JianLi0-0/Balancing-Cart/stm32/inverted_single_pendulum/balanced_car/balanced_car.pdf

## balanced_car Project Configuration Report

# 1. Description

## 1.1. Project

Project Name | balanced_car
Board Name | custom
Generated with: | STM32CubeMX 4.26.0
Date | 03/05/2019

## 1.2. MCU

MCU Series | STM32F1
MCU Line | STM32F103
MCU name | STM32F103C8Tx
MCU Package | LQFP48
MCU Pin number | 48

# 2. Pinout Configuration

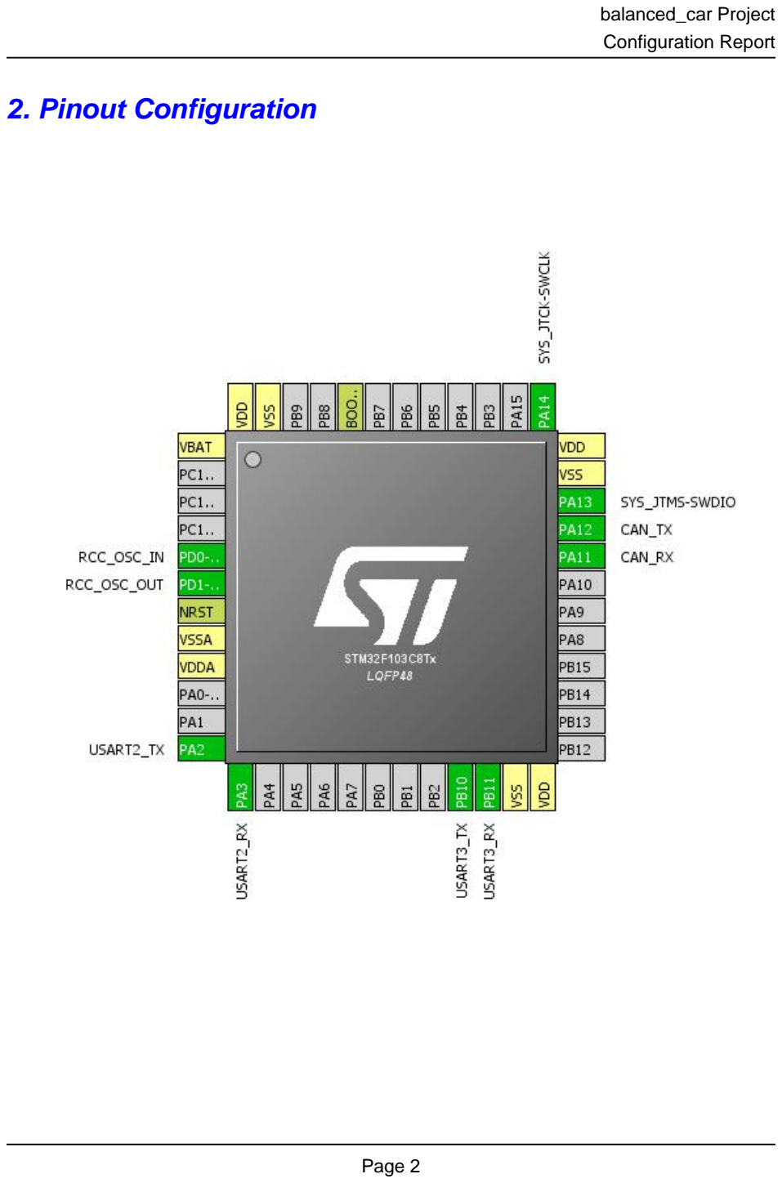
[picture p1: page 2]

# 3. Pins Configuration

Pin Number LQFP48 | Pin Name (function after reset) | Pin Type | Alternate Function(s) | Label
1 | VBAT | Power
5 | PD0-OSC_IN | I/O | RCC_OSC_IN
6 | PD1-OSC_OUT | I/O | RCC_OSC_OUT
7 | NRST | Reset
8 | VSSA | Power
9 | VDDA | Power
12 | PA2 | I/O | USART2_TX
13 | PA3 | I/O | USART2_RX
21 | PB10 | I/O | USART3_TX
22 | PB11 | I/O | USART3_RX
23 | VSS | Power
24 | VDD | Power
32 | PA11 | I/O | CAN_RX
33 | PA12 | I/O | CAN_TX
34 | PA13 | I/O | SYS_JTMS-SWDIO
35 | VSS | Power
36 | VDD | Power
37 | PA14 | I/O | SYS_JTCK-SWCLK
44 | BOOT0 | Boot
47 | VSS | Power
48 | VDD | Power

# 4. Clock Tree Configuration

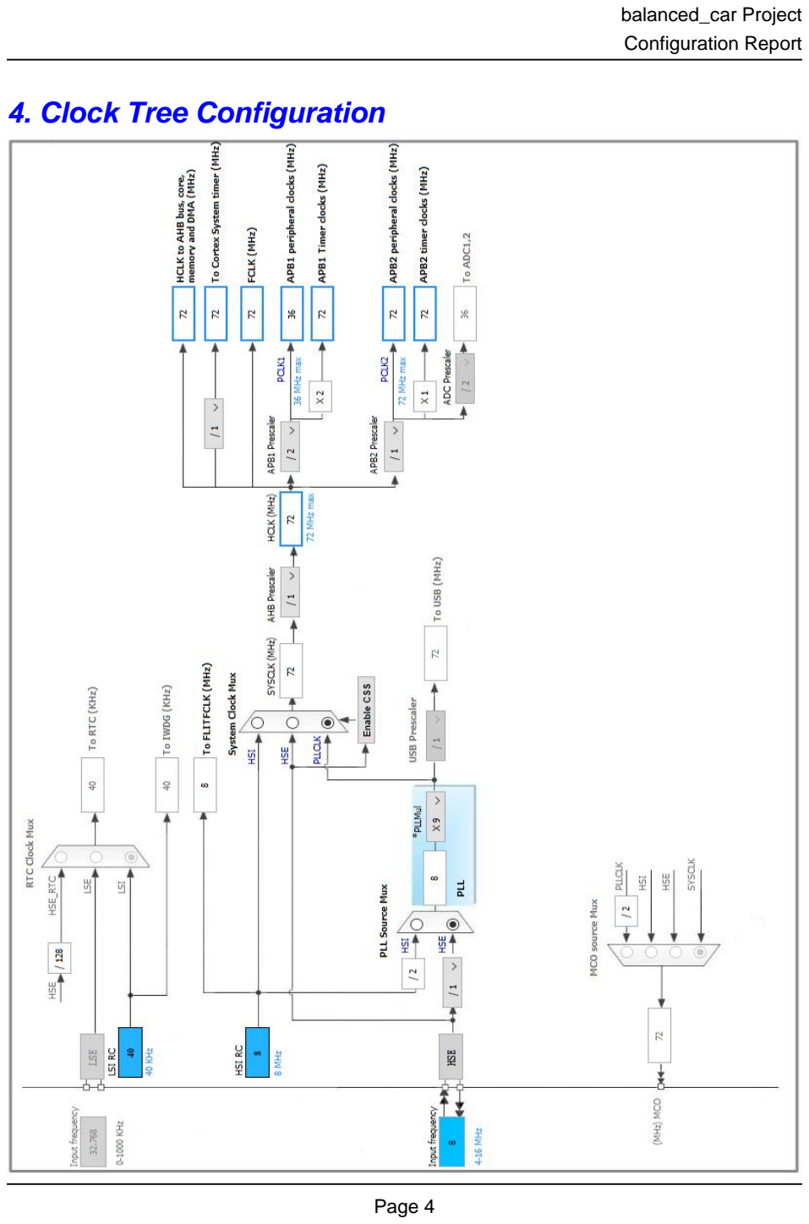
[picture p2: page 4]

# 5. IPs and Middleware Configuration

# 5.1. CAN

## mode: Mode 5.1.1. Parameter Settings:

### Bit Timings Parameters:

Prescaler (for Time Quantum) | 4 *
Time Quantum | 111.11111111111111 *
Time Quanta in Bit Segment 1 | 5 Times *
Time Quanta in Bit Segment 2 | 3 Times *
Time for one Bit | 333 *
ReSynchronization Jump Width | 1 Time

### Basic Parameters:

Time Triggered Communication Mode | Disable
Automatic Bus-Off Management | Disable
Automatic Wake-Up Mode | Disable
No-Automatic Retransmission | Disable
Receive Fifo Locked Mode | Disable
Transmit Fifo Priority | Disable

### Advanced Parameters:

Operating Mode | Normal

# 5.2. RCC

## High Speed Clock (HSE): Crystal/Ceramic Resonator 5.2.1. Parameter Settings:

### System Parameters:

VDD voltage (V) | 3.3
Prefetch Buffer | Enabled
Flash Latency(WS) | 2 WS (3 CPU cycle)

### RCC Parameters:

HSI Calibration Value | 16
HSE Startup Timout Value (ms) | 100
LSE Startup Timout Value (ms) | 5000

# 5.3. SYS

## Debug: Serial Wire Timebase Source: SysTick

# 5.4. TIM2

## Clock Source : Internal Clock 5.4.1. Parameter Settings:

### Counter Settings:

Prescaler (PSC - 16 bits value) | 3600-1 *
Counter Mode | Up
Counter Period (AutoReload Register - 16 bits value ) | 0
Internal Clock Division (CKD) | No Division
auto-reload preload | Disable

### Trigger Output (TRGO) Parameters:

Master/Slave Mode (MSM bit) | Disable (Trigger input effect not delayed)
Trigger Event Selection | Reset (UG bit from TIMx_EGR)

# 5.5. USART2

## Mode: Asynchronous 5.5.1. Parameter Settings:

### Basic Parameters:

Baud Rate | 115200
Word Length | 8 Bits (including Parity)
Parity | None
Stop Bits | 1

### Advanced Parameters:

Data Direction | Receive and Transmit
Over Sampling | 16 Samples

# 5.6. USART3

## Mode: Asynchronous

## 5.6.1. Parameter Settings:

### Basic Parameters:

Baud Rate | 115200
Word Length | 8 Bits (including Parity)
Parity | None
Stop Bits | 1

### Advanced Parameters:

Data Direction | Receive and Transmit
Over Sampling | 16 Samples

### * User modified value

# 6. System Configuration

# 6.1. GPIO configuration

IP | Pin | Signal | GPIO mode | GPIO pull/up pull down | Max Speed | User Label
CAN | PA11 | CAN_RX | Input mode | No pull-up and no pull-down | n/a
| PA12 | CAN_TX | Alternate Function Push Pull | n/a | High *
RCC | PD0-OSC_IN | RCC_OSC_IN | n/a | n/a | n/a
| PD1-OSC_OUT | RCC_OSC_OUT | n/a | n/a | n/a
SYS | PA13 | SYS_JTMS-SWDIO | n/a | n/a | n/a
| PA14 | SYS_JTCK-SWCLK | n/a | n/a | n/a
USART2 | PA2 | USART2_TX | Alternate Function Push Pull | n/a | High *
| PA3 | USART2_RX | Input mode | No pull-up and no pull-down | n/a
USART3 | PB10 | USART3_TX | Alternate Function Push Pull | n/a | High *
| PB11 | USART3_RX | Input mode | No pull-up and no pull-down | n/a

# 6.2. DMA configuration

## nothing configured in DMA service

# 6.3. NVIC configuration

Interrupt Table | Enable | Preenmption Priority | SubPriority
Non maskable interrupt | true | 0 | 0
Hard fault interrupt | true | 0 | 0
Memory management fault | true | 0 | 0
Prefetch fault, memory access fault | true | 0 | 0
Undefined instruction or illegal state | true | 0 | 0
System service call via SWI instruction | true | 0 | 0
Debug monitor | true | 0 | 0
Pendable request for system service | true | 0 | 0
System tick timer | true | 0 | 0
USB high priority or CAN TX interrupts | true | 0 | 0
USB low priority or CAN RX0 interrupts | true | 0 | 0
TIM2 global interrupt | true | 0 | 0
USART2 global interrupt | true | 0 | 0
USART3 global interrupt | true | 0 | 0
PVD interrupt through EXTI line 16 | unused
Flash global interrupt | unused
RCC global interrupt | unused
CAN RX1 interrupt | unused
CAN SCE interrupt | unused

### * User modified value

# 7. Power Consumption Calculator report

### 7.1. Microcontroller Selection

Series | STM32F1
Line | STM32F103
MCU | STM32F103C8Tx
Datasheet | 13587_Rev17

### 7.2. Parameter Selection

Temperature | 25
Vdd | 3.3

# 8. Software Project

## 8.1. Project Settings

Name | Value
Project Name | balanced_car
Project Folder | G:\MX\balanced_car
Toolchain / IDE | MDK-ARM V5
Firmware Package Name and Version | STM32Cube FW_F1 V1.6.1

## 8.2. Code Generation Settings

Name | Value
STM32Cube Firmware Library Package | Copy all used libraries into the project folder
Generate peripheral initialization as a pair of '.c/.h' files | Yes
Backup previously generated files when re-generating | No
Delete previously generated files when not re-generated | Yes
Set all free pins as analog (to optimize the power consumption) | No

# 9. Software Pack Report
