JianLi0-0/Balancing-Cart/simulation/truewheel.jpg

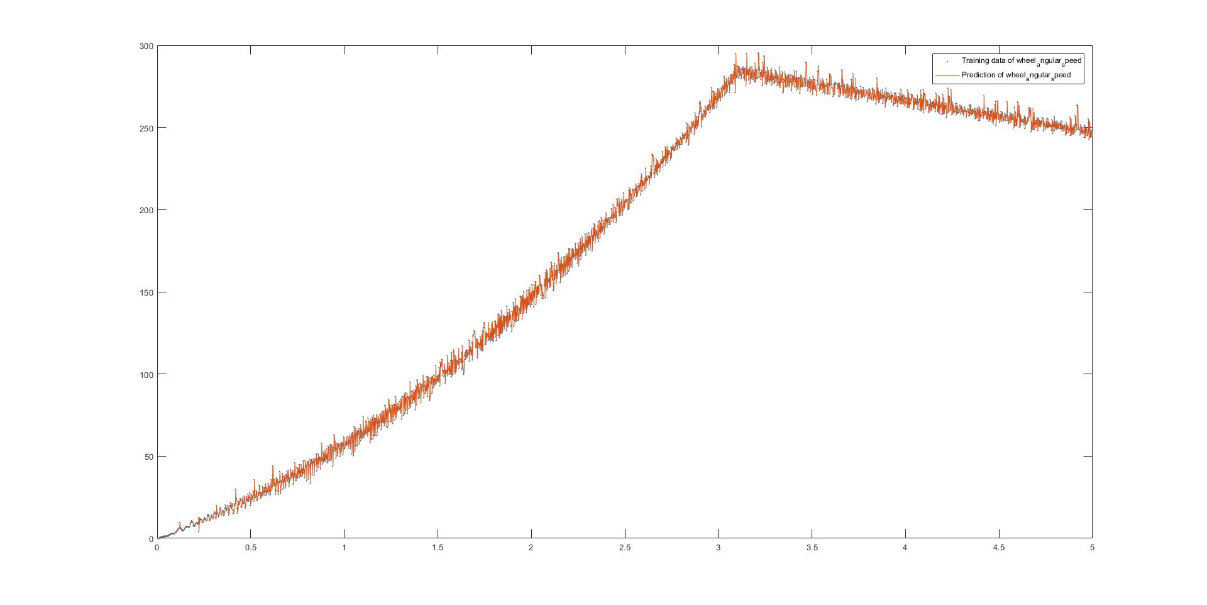
simulation/truewheel.jpg
