JianLi0-0/Balancing-Cart/solidworks/cart_assembly.SLDASM

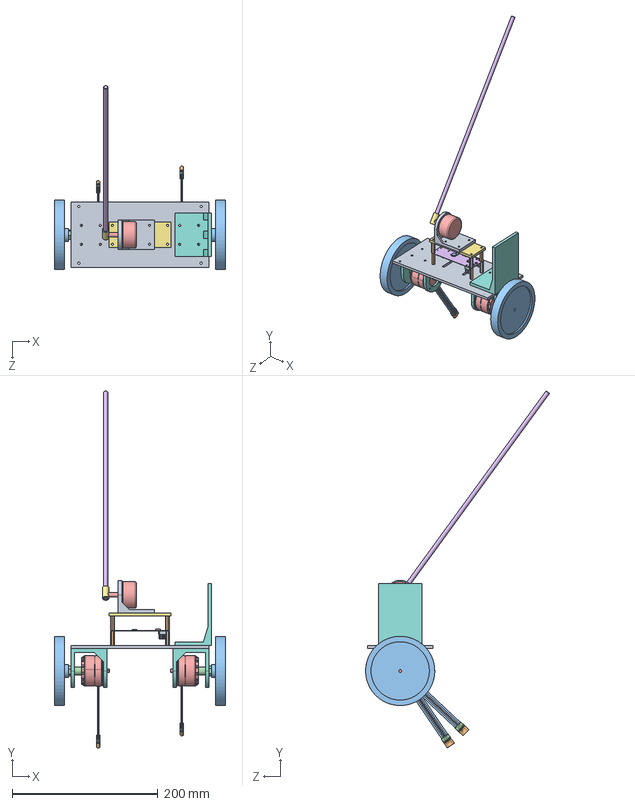
[picture p4: CAD file, 2019-11-14]
solidworks/cart_assembly.SLDASM
234.6 x 489.8 x 252.3 mm
bottom_board
19.STEP x 2
15.STEP x 6
20.STEP x 2
1.STEP x 2
4.STEP x 2
3.STEP x 2
motor_frame x 2
potentiometer_frame
Copper_Pillar x 8
wheel x 2
coupler x 2
potentiometer
rod
rod_coupler
Extruded.step x 2
Extruded-0.step
Extruded-1.step
LQFP48_7x7______.step
_____0.25.step x 48
Extruded-2.step
Board.step
top_board
tag_frame
