JianLi0-0/Balancing-Cart/solidworks/M3508.SLDASM

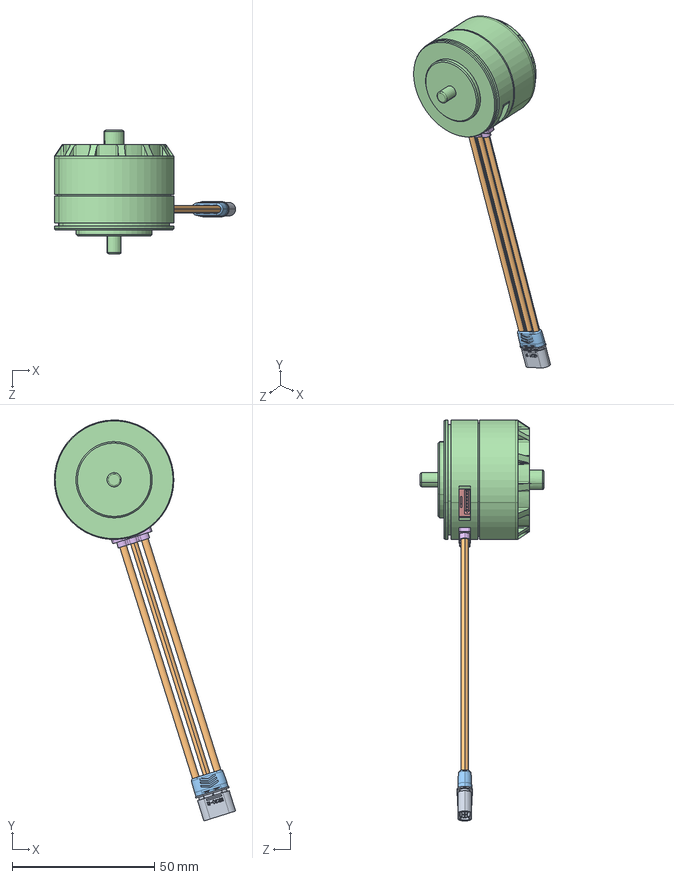
[picture p5: CAD file, 2019-11-14]
solidworks/M3508.SLDASM
63.7 x 140.9 x 43.4 mm
19.STEP
15.STEP x 3
20.STEP
1.STEP
4.STEP
3.STEP
