JianLi0-0/Balancing-Cart/solidworks/motor_frame.SLDPRT

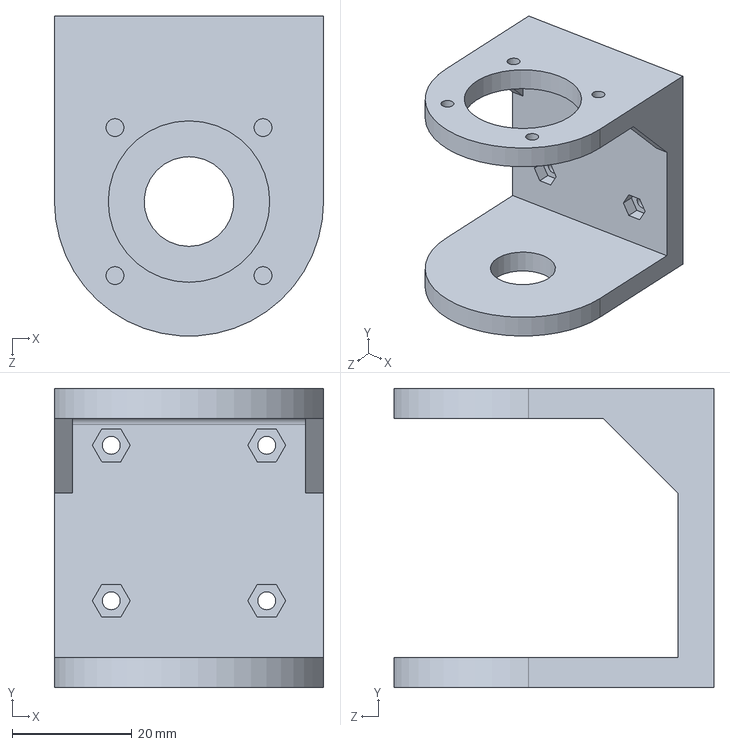
[picture p6: CAD file, 2019-11-14]
solidworks/motor_frame.SLDPRT
45.0 x 50.0 x 53.4 mm
