JianLi0-0/Balancing-Cart/solidworks/tag_frame.SLDPRT

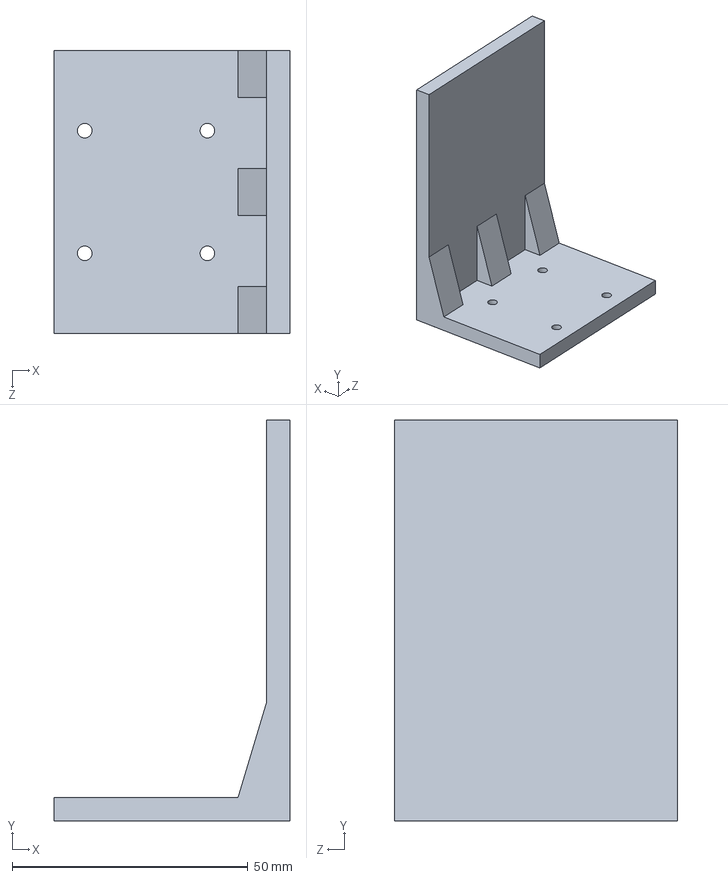
[picture p7: CAD file, 2019-11-14]
solidworks/tag_frame.SLDPRT
50.0 x 85.0 x 60.0 mm
