JianLi0-0/Balancing-Cart/solidworks/电池.SLDPRT

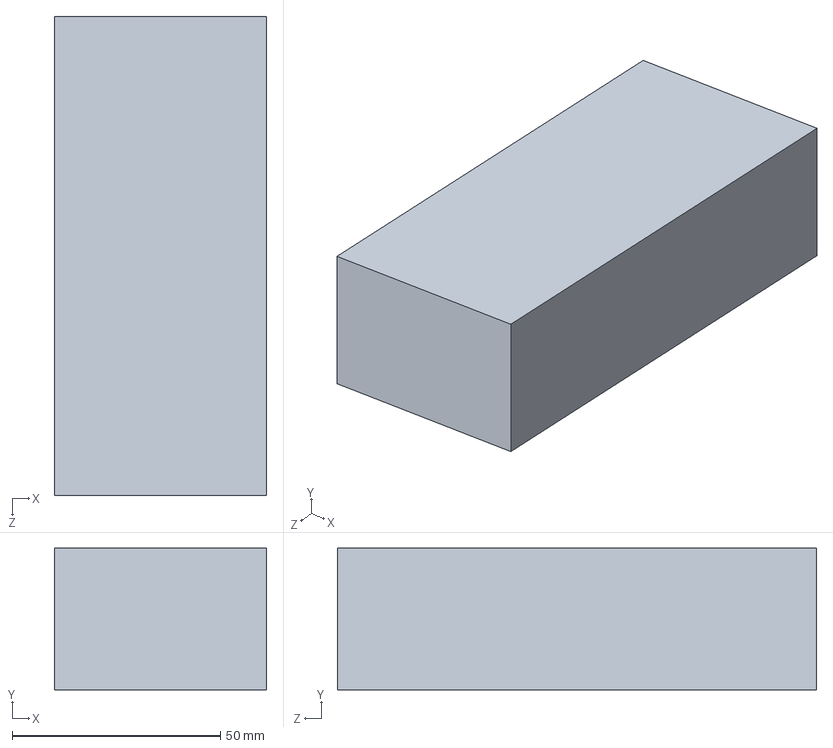
[picture p8: CAD file, 2019-11-14]
solidworks/电池.SLDPRT
51.0 x 34.0 x 115.0 mm
