JianLi0-0/Balancing-Cart/solidworks/bottom_board.SLDPRT

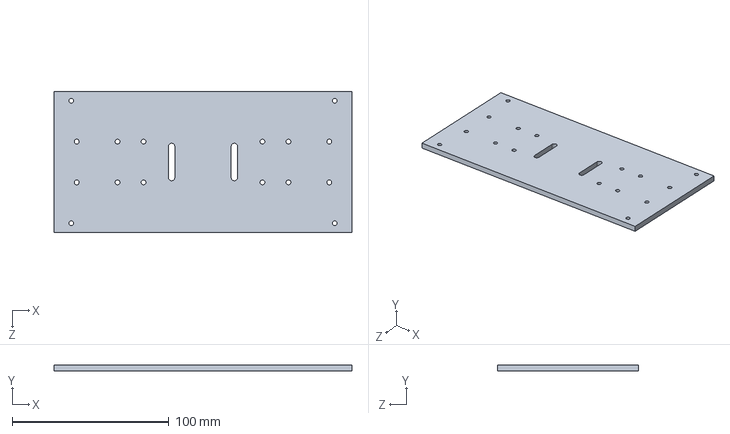
[picture p9: CAD file, 2019-11-14]
solidworks/bottom_board.SLDPRT
190.0 x 4.00 x 90.0 mm
