JianLi0-0/Balancing-Cart/solidworks/rod.SLDPRT

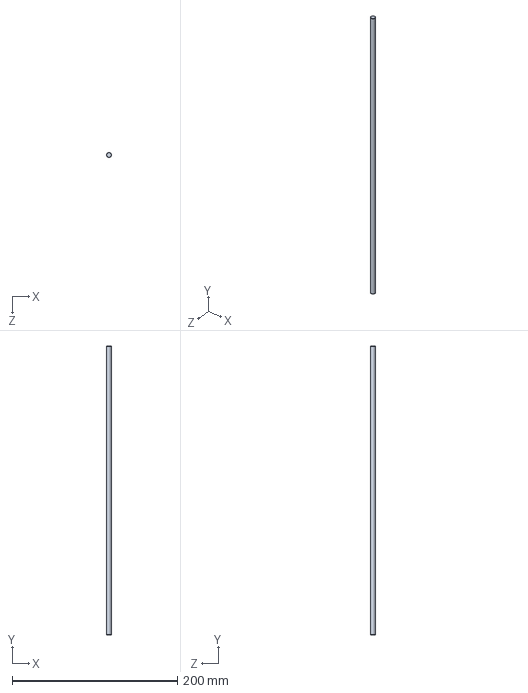
[picture p10: CAD file, 2019-11-14]
solidworks/rod.SLDPRT
6.00 x 350.0 x 6.00 mm
