JianLi0-0/Balancing-Cart/solidworks/potentiometer_frame.SLDPRT

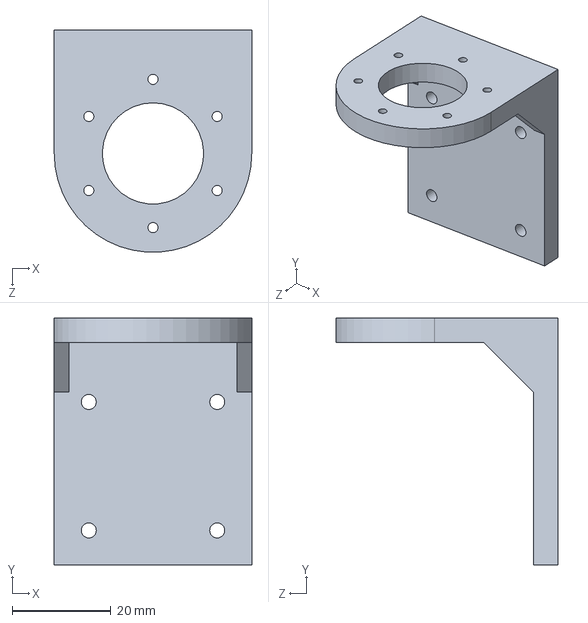
[picture p11: CAD file, 2019-11-14]
solidworks/potentiometer_frame.SLDPRT
40.0 x 50.0 x 45.0 mm
