JianLi0-0/Balancing-Cart/solidworks/potentiometer.SLDPRT

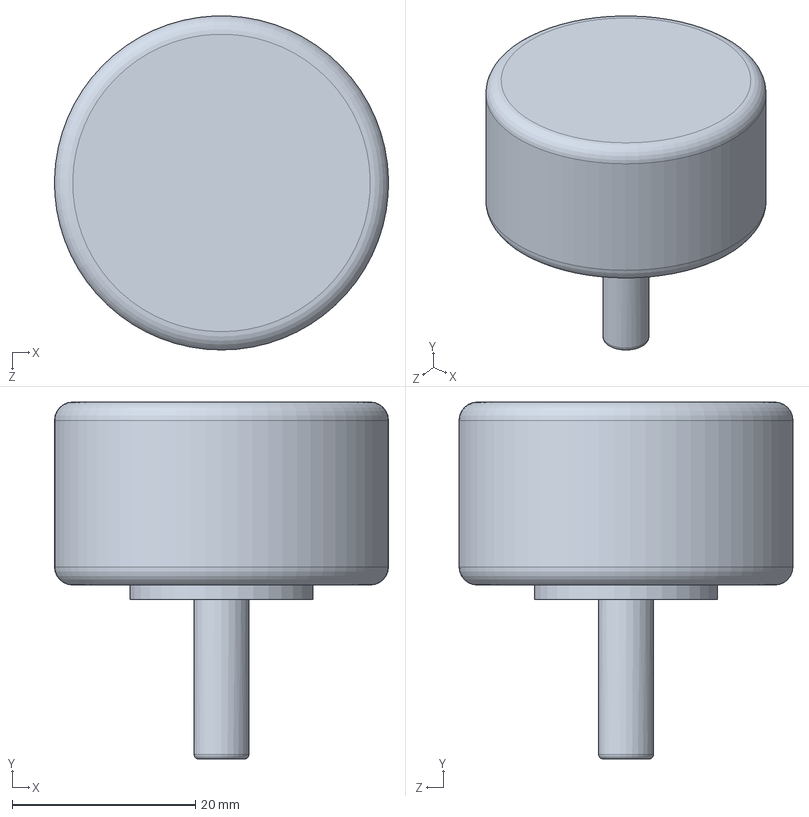
[picture p12: CAD file, 2019-11-14]
solidworks/potentiometer.SLDPRT
36.5 x 39.0 x 36.5 mm
