JianLi0-0/Balancing-Cart/solidworks/top_board.SLDPRT

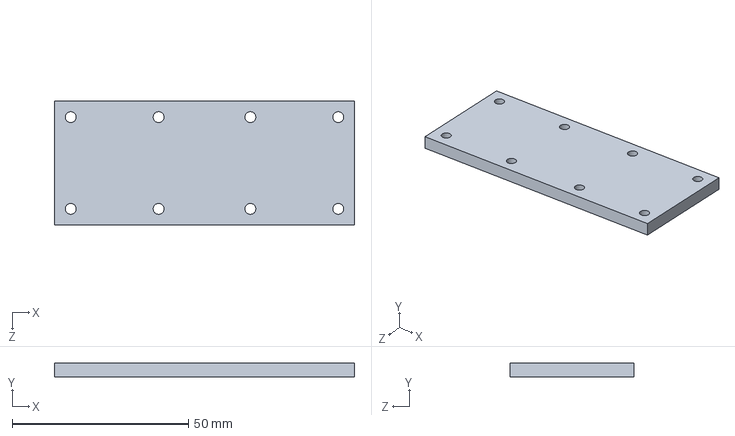
[picture p13: CAD file, 2019-11-14]
solidworks/top_board.SLDPRT
85.0 x 4.00 x 35.0 mm
