JianLi0-0/Balancing-Cart/solidworks/rod_coupler.SLDPRT

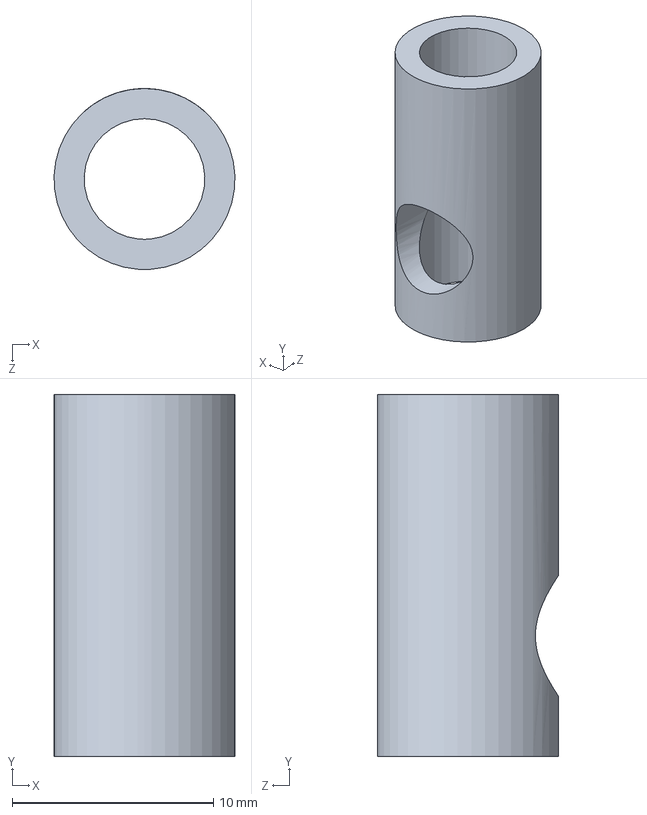
[picture p14: CAD file, 2019-11-14]
solidworks/rod_coupler.SLDPRT
8.99 x 18.0 x 9.00 mm
