JianLi0-0/Balancing-Cart/solidworks/Balance_car.step

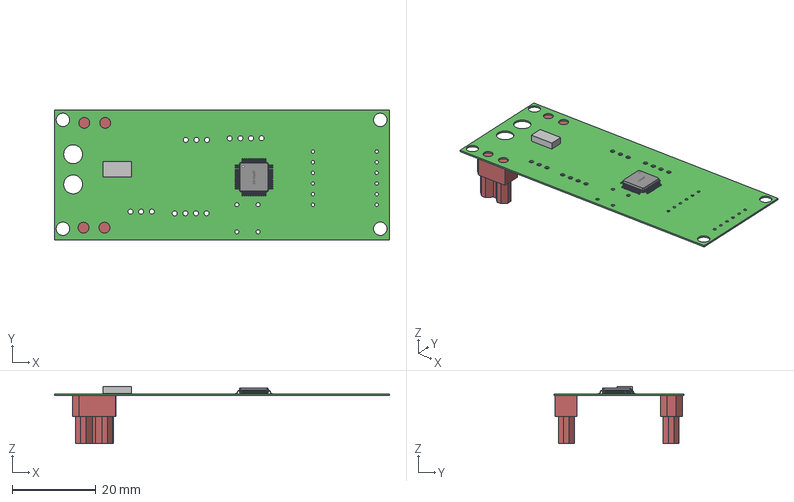
[picture p15: CAD file, 2019-11-14]
solidworks/Balance_car.step
80.0 x 31.0 x 13.7 mm
Board
Extruded x 5
LQFP48_7x7__呿极
竘褐_0.25 x 48
LOGO?0.25
