JianLi0-0/Balancing-Cart/solidworks/Copper_Pillar.SLDPRT

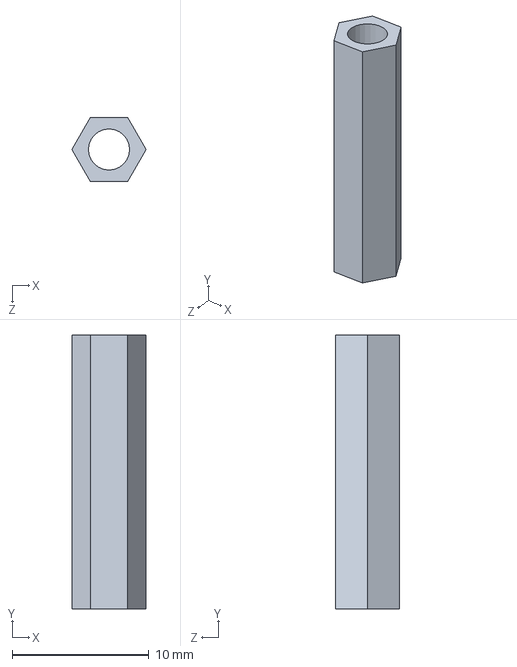
[picture p16: CAD file, 2019-11-14]
solidworks/Copper_Pillar.SLDPRT
5.43 x 20.0 x 4.70 mm
