JianLi0-0/Balancing-Cart/solidworks/wheel.SLDPRT

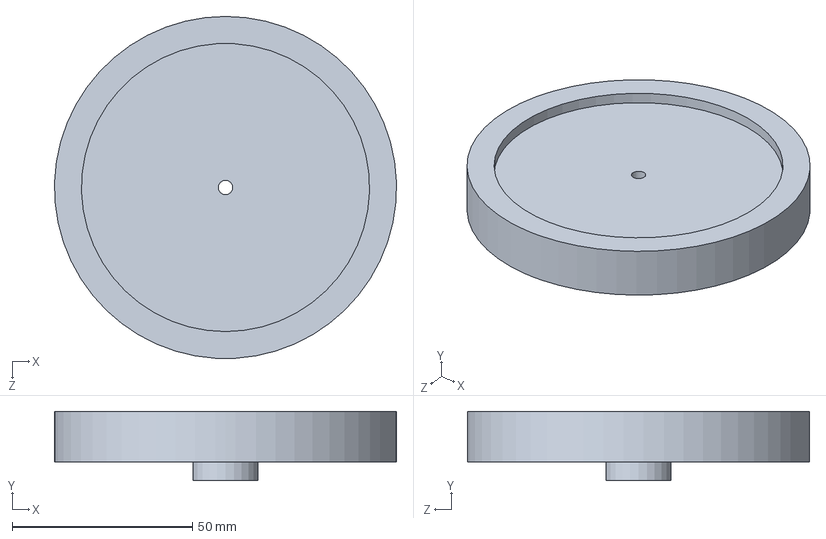
[picture p17: CAD file, 2019-11-14]
solidworks/wheel.SLDPRT
95.0 x 19.2 x 95.0 mm
