JianLi0-0/Balancing-Cart/solidworks/coupler.SLDPRT

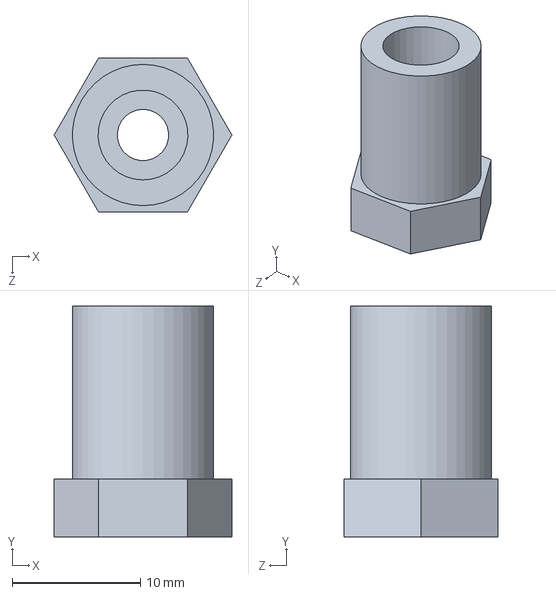
[picture p18: CAD file, 2019-11-14]
solidworks/coupler.SLDPRT
13.9 x 18.0 x 12.0 mm
