JianLi0-0/Balancing-Cart/(list of files, cad)

Other CAD files:
solidworks/bottom_board.STL
solidworks/motor_frame.STL
solidworks/potentiometer_frame.STL
solidworks/top_board.STL
