JianLi0-0/Balancing-Cart/tutorials/两轮平衡车-LQR.docx

基于LQR控制的平衡小车

机器人学院二期 机电 李坚

1、 简介：

本项目的目的是在构建一个完整控制系统的过程中掌握使用动力学方程建模、分析，设计控制器的能力。涉及到电路设计，分析力学，基于模型的控制。平衡小车本质上是一个倒立摆，而倒立摆则是一个经典的控制对象，其本身是一个不稳定的非线性系统。控制目标是通过控制电机来保持平衡小车直立以及水平方向上的零位移，因此这是一个单输入多输出的系统。经典的控制理论只能解决单输入单输出的问题，因此需要用到现代控制理论进行分析、设计控制器。

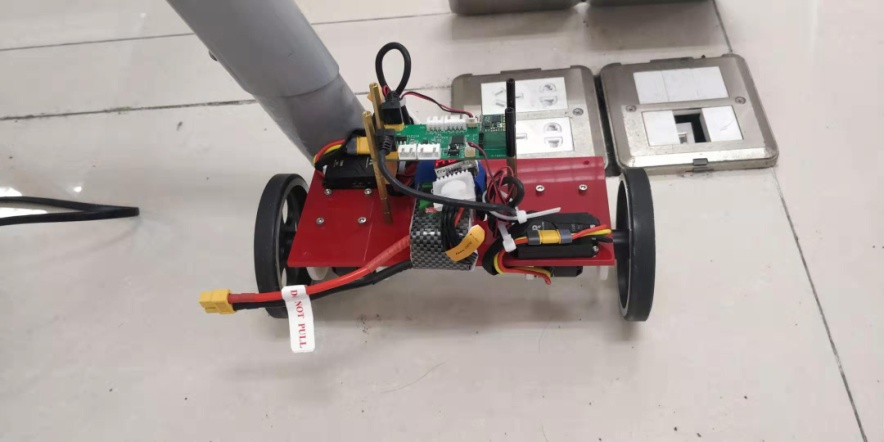
[picture p19: figure]

2、 数学模型推导：

物理模型示意图如下：

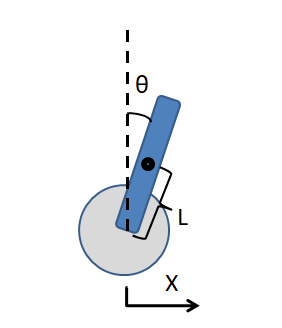
[picture p20: figure]

M_W | 轮子质量 | 0.134 kg
M_b | 底盘质量 | 0.790 kg
I_w | 轮子转动惯量 | 未知
I_b | 底盘转动惯量 | 未知
R | 轮子半径 | 0.0475 m
K_m | 电机常数 | 0.0156 Nm/A
u | 电机目标电流 | 系统输入
C_(wb) | 电机转子定子阻尼系数 | 未知

平衡小车系统涉及到两个物体的相互作用，此处运用欧拉-拉格朗日方程来推导本系统的数学模型。

欧拉-拉格朗日方程定义如下：

d/(dt)((∂L)/(∂qi))-(∂L)/(∂qi)=Qi-(∂D)/(∂qi)

其中

L=T-V

D=1/2CV^2

T为系统动能，V为系统势能，D为运动过程中耗散的能量

选定X与θ作为广义坐标，规定顺时针旋转为θ正方向，水平向右为X正方向，记cosθ为Cθ、sinθ为Sθ则有

T=2T_w +T_b

V=V_b +T_w

单个轮子动能

T_w =1/2M_w X^2 +1/2I_w (X^2)/(R^2)

T_b =1/2M_b [(X+LCθ·θ)^2 +(LSθ·θ)^2 ]+1/2I_b θ^2

V_w =0

V_b =M_b gLCθ

D=2·1/2CV^2

关于X有：

(2M_W +2(I_w)/(R^2)+M_b )X+M_b LCθ·θ-M_b LSθ·θ^2 =2(uK_m)/R-2(C_(wb))/R(X/R-θ)

关于θ有:

M_b LCθX-M_b LSθ·θX+(M_b L^2 +I_b )θ+M_b LSθ·θX-M_b gLSθ=-2uK_m -2C_(wb) (θ-X/R)

倒立摆是一个非线性系统，比较复杂。我们的目的是为了使小车保持直立，即θ=0，因此我们可以在θ=0处对其进行线性化。 (Cθ≈1,Sθ≈θ,θθ≈0)

因此在平衡点附近的动力学方程为：

(2M_W +2(I_w)/(R^2)+M_b )X+M_b Lθ+2(C_(wb))/(R^2)X-2(C_(wb))/Rθ=2(K_m)/Ru

M_b LX+(M_b L^2 +I_b )θ-M_b gLθ-2(C_(wb))/RX+2C_(wb) θ=-2K_m u

3、 系统辨识：

由于小车底盘与轮子不是规则形状，无法直接计算其转动惯量，也无法得知小车底盘质心到电机轴的距离，电机转子与定子的阻尼系数也无法直接得知，因此需要做实验通过最小二乘法来求得。

轮子的动力学差分方程为：

I_w (θ_w (k)-θ_w (k-1))/T=K_m u(k-1)-θ_w (k-1)C_(wb)

可化成：

θ_w (k)=(I_w -C_(wb) T)/(I_w)θ_w (k-1)+(K_m T)/(I_w)u(k-1)

令 y=θ_w ，x=u ，有

Y=[, θ_w (1+1), θ_w (1+2), ⋮, θ_w (1+N)] X=[θ_w (1), u(1)θ_w (2), u(2)⋮, ⋮θ_w (4), u(4)] K=[(I_w -C_(wb) T)/(I_w)(K_m T)/(I_w)]

K=(X^T X)^(-1) X^T Y

求出K后，解方程可得到 I_w =0.000020 与 C_(wb) =0.000098

实验数据：

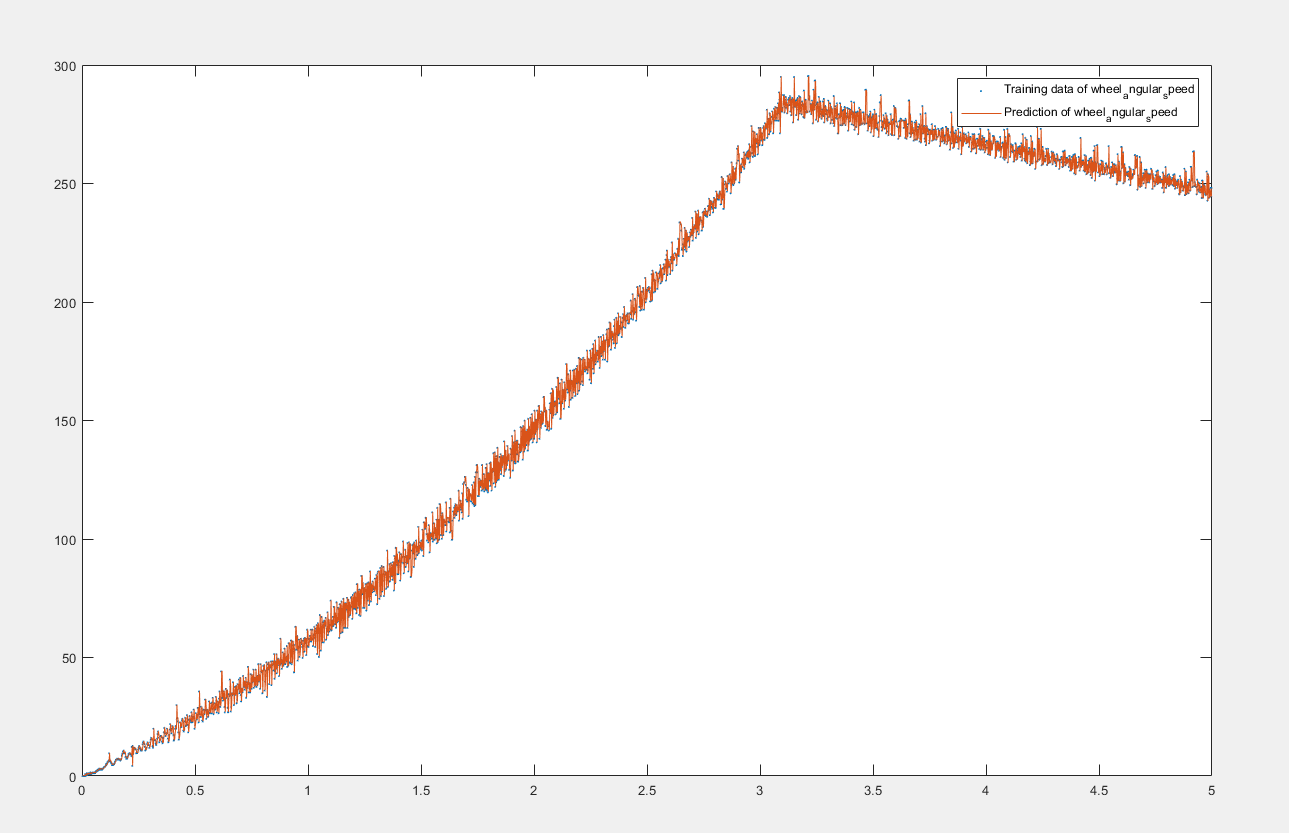
[picture p21: figure]

小车底盘的动力学差分方程为：

I_b (θ(k)-θ(k-1))/T=M_b Lg·Sθ(k-1)-2C_(wb) θ(k-1)

可化成：

θ(k)=(I_b -2TC_(wb))/(I_b)θ(k-1)+(M_b LgT)/(I_b)Sθ(k-1)

令 y=θ，x=Sθ ，有

Y=[, θ(1+1), θ(1+2), ⋮, θ(1+N)] X=[θ(1), Sθ(1)θ(2), Sθ(2)⋮, ⋮θ(N), Sθ(N)] K=[(I_b -2C_(wb) T)/(I_b)(M_b LgT)/(I_b)]

求出K后，解方程可得到 I_b =0.000311 与 L=0.005

实验数据：

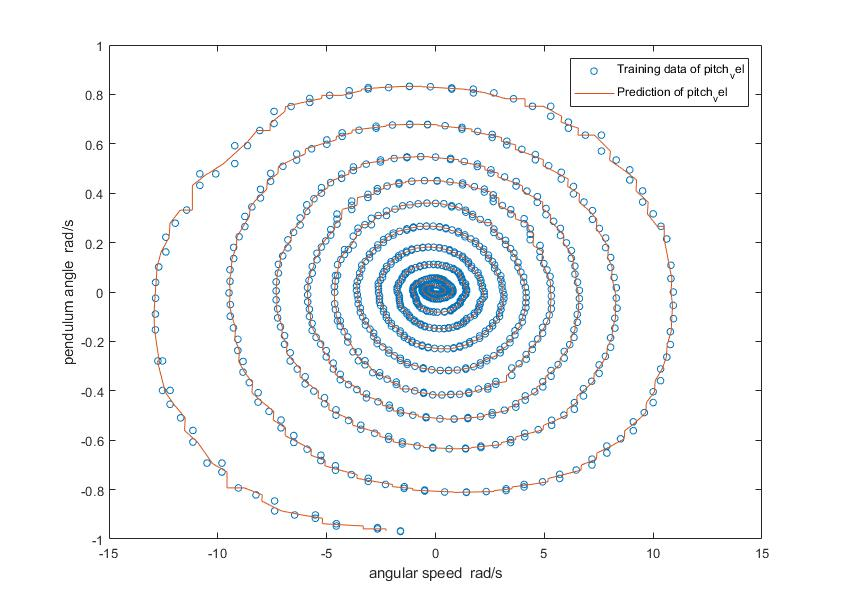
[picture p22: figure]
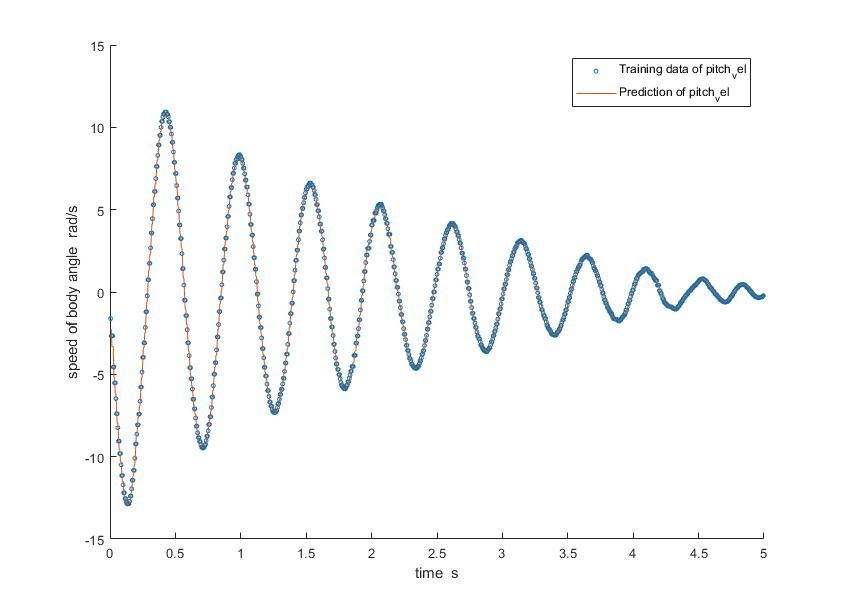
[picture p23: figure]

4、 基于模型的控制-LQR：

令 E=[2M_w +(2I_w)/(R^2)+M_b , M_b LM_b L, M_b L^2 +I_b ]

F=[(2C_(wb))/(R^2), -(2C_(wb))/R-(2C_(wb))/R, 2C_(wb) ]

G=[0, 00, -M_b gL]

H=[(2K_m)/R-2K_m ]

系统的动力学方程可写成：

E[Xθ]+F[Xθ]+G[Xθ]=H·i

选取状态变量 X(t)=[XθXθ] ，则 X(t)=[XθXθ] ， u(t)=i

因此状态方程为

X(t)=AX(t)+Bu(t)

其中

A=[0 0, 1 00 0, 0 1-E^(-1) G, -E^(-1) F]_(4x4)

B=[00E^(-1) H]_(4x1)

所选取的状态变量均可用传感器测量，现在来讨论其能控性。

rank(B AB A^2 B A^3 B)=4

则系统完全能控。

线性二次型调节器（LQR）是一种基于模型控制的策略。

定义性能指标：

J=1/2∫_(t0)^(∞) [x^T (t)Qx(t)+u^T (t)Ru(t)]dt

Q与R是加权矩阵，通过调节Q与R可以改善控制效果。

解黎卡提方程

PA+A^T P+Q-PBR^(-1) BP=0

得状态反馈控制律：

u(t)=-Kx(t)

其中

K=R^(-1) B^T P

5、 展望：

1.改进成二级倒立摆：

2.运用卡尔曼滤波器处理陀螺仪与加速度计原始数据，进行状态估计

3.自适应控制理论
