JianLi0-0/Balancing-Cart/(list of files, drawings)

Other design files:
ad/Balance_car.PcbDoc
ad/Balance_car.PrjPCB
ad/PCBlib.PcbLib
ad/RoboFly.PcbLib
ad/SCHlib.SchLib
ad/Sheet1.SchDoc
ad/羽毛球团队.PcbLib
ad/羽毛球团队.SCHLIB
