JianLi0-0/Balancing-Cart/stm32/inverted_single_pendulum/balanced_car/balanced_car.ioc

Mcu.UserName=STM32F103C8Tx
PA11.Signal=CAN_RX
PA12.Signal=CAN_TX
PA13.Signal=SYS_JTMS-SWDIO
PA14.Signal=SYS_JTCK-SWCLK
PA2.Signal=USART2_TX
PA3.Signal=USART2_RX
PB10.Signal=USART3_TX
PB11.Signal=USART3_RX
PD0-OSC_IN.Signal=RCC_OSC_IN
PD1-OSC_OUT.Signal=RCC_OSC_OUT
